bandianxuediao/TTP229_TouchPad/project_process.md

# TT229_TouchPad
 使用TTP229触摸控制芯片开发的一款4x4触摸矩阵键盘，两片74hc595级联控制16个双色LED灯。<br/>

>2018年4月30日<br/>
>>创建原理图，收集一些文档资料<br/>

>2018年5月5月10日<br/>
>>测试代码完成，开始V2版本布局布线<br/>
>>第一版本是为了快速验证方案，第二版又修改了LED控制方式，使用一个引脚控制两个灯。

>2018年5月12日<br/>
>>V2版电路板投板

芯片返回有错，事事不顺啊。

>2018年5月27日 23:30
>>第三版焊接之后发现还是有问题，干扰太大。不知从何入手，已经给官方技术支持发邮件，等待回复！</br>
>>看这板子发呆，突然想到会不会跟我喊姐有关系呢？芯片上面残留了不少的松香，松香会不会导致TTP229的因脚趾间短路呢？万用表一个一个的测了一遍完全没有短路的迹象啊。

>2018年5月28日 23:45
>>昨天晚上考虑松香的问题，早起就把一块焊好的板子装进包里带到公司使用公司的洗板水好好刷了一下。（洗板水已购买，暂未到货。）并在上班之前使用STM32F103C8T6核心板简单测试了一下，意外地发现效果还不错。于是欢喜的装回包里，晚上回来又换回正点原子精英板测试。发现效果又变差了，但总体上比清洗松香之前改善了很多。只敢小心翼翼的去按按键，不舍得做暴力测试。

>2018年5月30日 0:50
>>29日加班回来就焊接完成另外一块板子，在测试的过程中不经意的拿了一个立创商城的小的原件袋敷在案件上面。就是这一个不经意的举动，却足以一扫这些日子聚集在心头的阴霾。因为这个测试结果实在太漂亮了，按键的干扰几乎可以忽略不计。虽然不知道具体原因是什么，但是想来那么多的厂家没有将PCB直接露出来给客户按的也就有些理解了。</br>
>>翻出之前买的TTP229Demo板，发现它的按键上面全部都是盖油的。然后搜索了淘宝的一些触摸按键产品，根据他们贴出来的图片也能很明显的观察出来多数都是PCB按键上面盖油处理。</br>
>>OK,这次算是真相大白了。终于可以睡个安生觉了。**安安**
