bandianxuediao/TTP229_TouchPad/DXP/PCB1--BOOM.xlsx

Comment | Designator | Footprint | LibRef | Quantity
102 | C1 | 0603p | 电容-NPO-0603 | 1
104 | C2, C10, C11 | 0603p | 电容-NPO-0603 | 3
15pF | C3, C9 | 0603p | Cap | 2
22pF(再选择22-50之间容值备用) | C4, C5, C7, C8 | 0603p | Cap | 4
2xLED | D1, D2, D3, D4, D5, D6, D7, D8, D9, D10, D11, D12, D13, D14, D15, D16 | LED | 2xLED | 16
Header 5 | P1, P2 | XH-5P-2.54 | Header 5 | 2
1M | R3 | 0603p | 电阻-0603 | 1
10K | R5, R6 | 0603p | Res2 | 2
150R | R7, R8, R9, R10, R11, R12, R13, R14, R15, R16, R17, R18, R19, R20, R21, R22, R23, R24, R25, R26, R27, R28, R29, R30, R31, R32, R33, R34, R35, R36, R37, R38 | 0603p | 电阻-0603 | 32
TouchPad | TouchPad1, TouchPad5, TouchPad9, TouchPad13 | TOUCHKEYBIG | TouchPad | 4
TouchPad | TouchPad2, TouchPad3, TouchPad4, TouchPad6, TouchPad7, TouchPad8, TouchPad10, TouchPad11, TouchPad12, TouchPad14, TouchPad15, TouchPad16 | TOUCHKEY | TouchPad | 12
TTP229-L | U1 | LC-SSOP-28_150MIL | TTP229-L | 1
74HC595 | U2, U3 | LC-SOP-16_150MIL | 74HCT595 | 2
