bandianxuediao/TTP229_TouchPad/DXP/触摸键盘.DXF

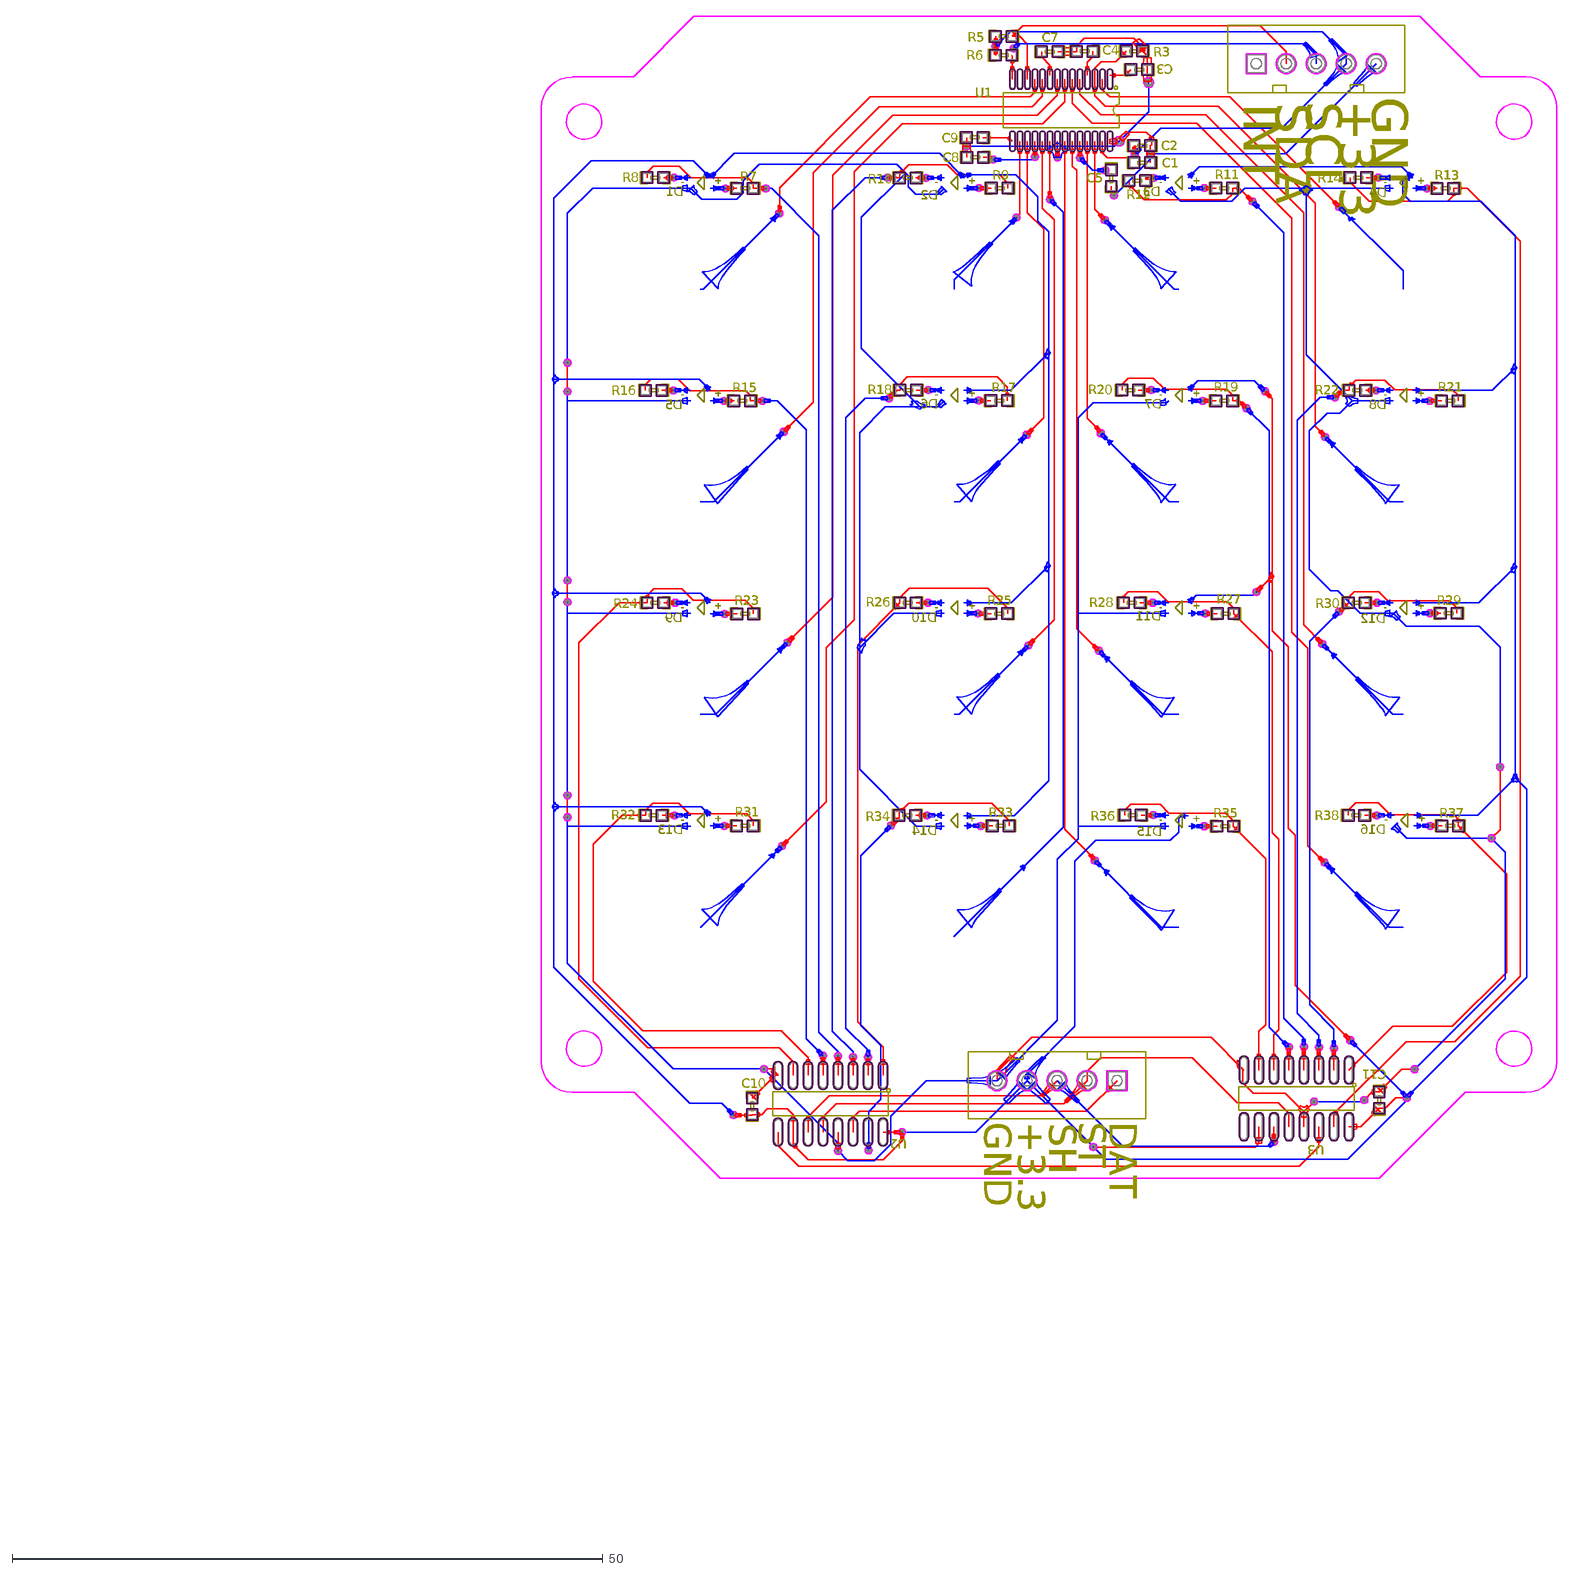
[picture p3: CAD file, 2018-06-02]
DXP/触摸键盘.DXF
GND
+3.3
SCL
SDA
INT
SH
ST
DAT
C1
C2
C3
C4
C5
C7
C8
C9
C10
C11
+
-
D1
D2
D3
D4
D5
D6
D7
D8
D9
D10
D11
D12
D13
D14
D15
D16
R3
R5
R6
R7
R8
R9
R10
R11
R12
R13
R14
R23
R24
R25
R26
R27
R28
R29
R30
U1
U2
U3
R15
R16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
