bandianxuediao/TTP229_TouchPad/(list of files, cad)

Other CAD files:
DOC/16键键盘带读卡.dwg
