bandianxuediao/TTP229_TouchPad/DXP/PCB_Project1.pdf

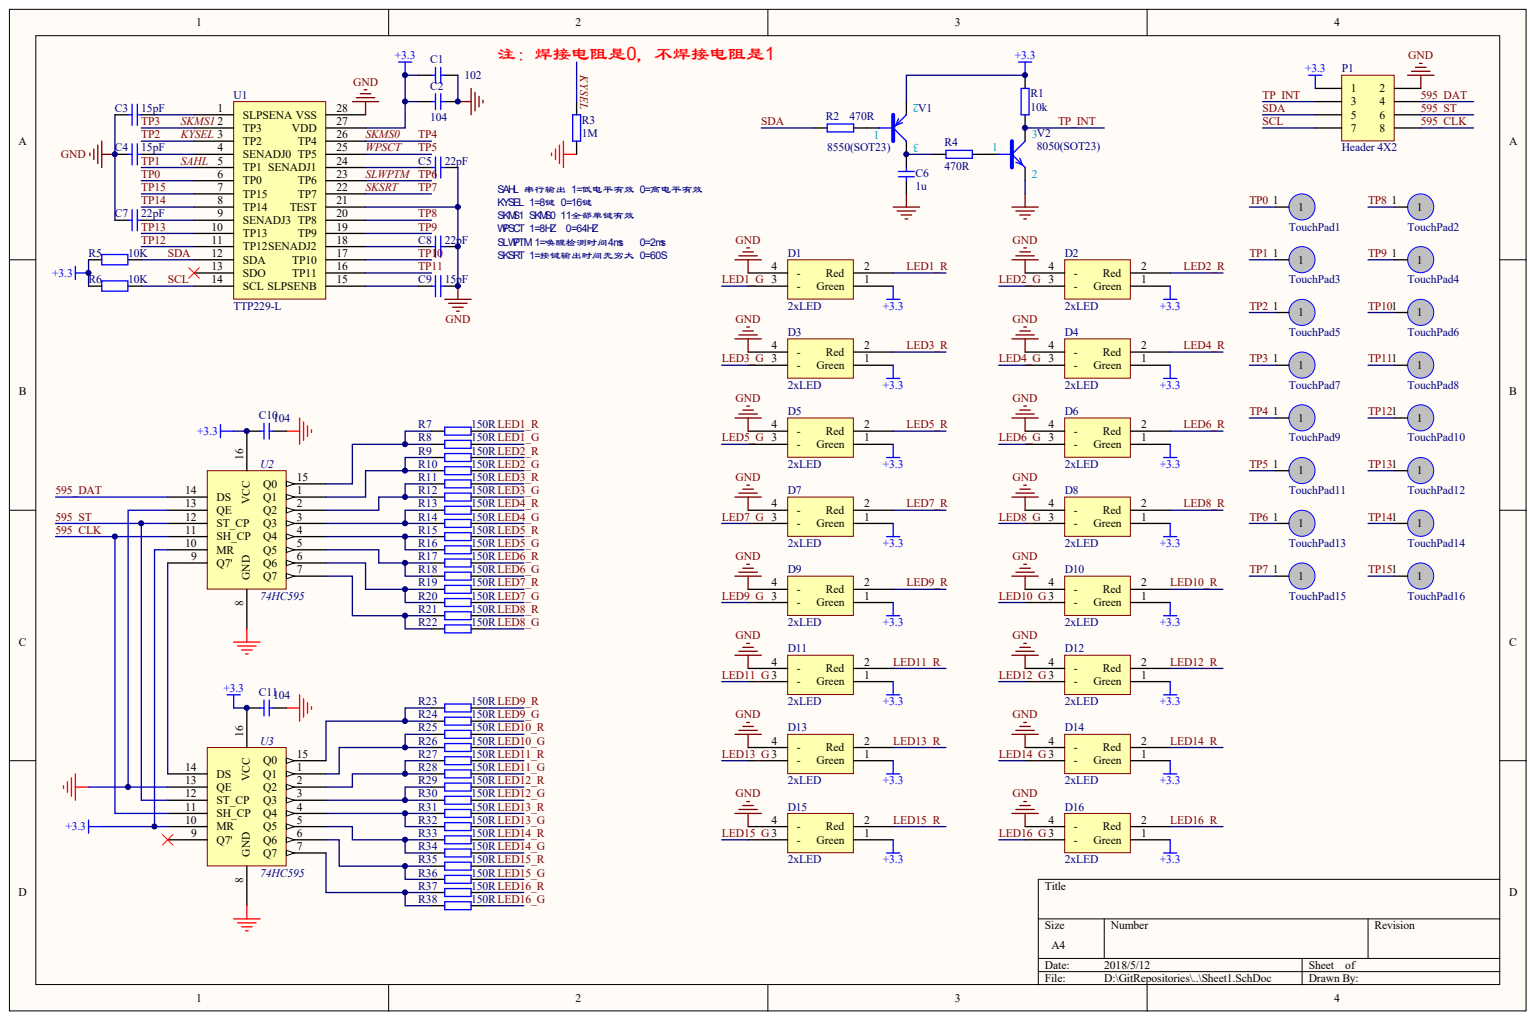
[picture p4: page 1]

22p F 9 | 2 0 T P
T P 1 3 1 0 | 1 9 T P

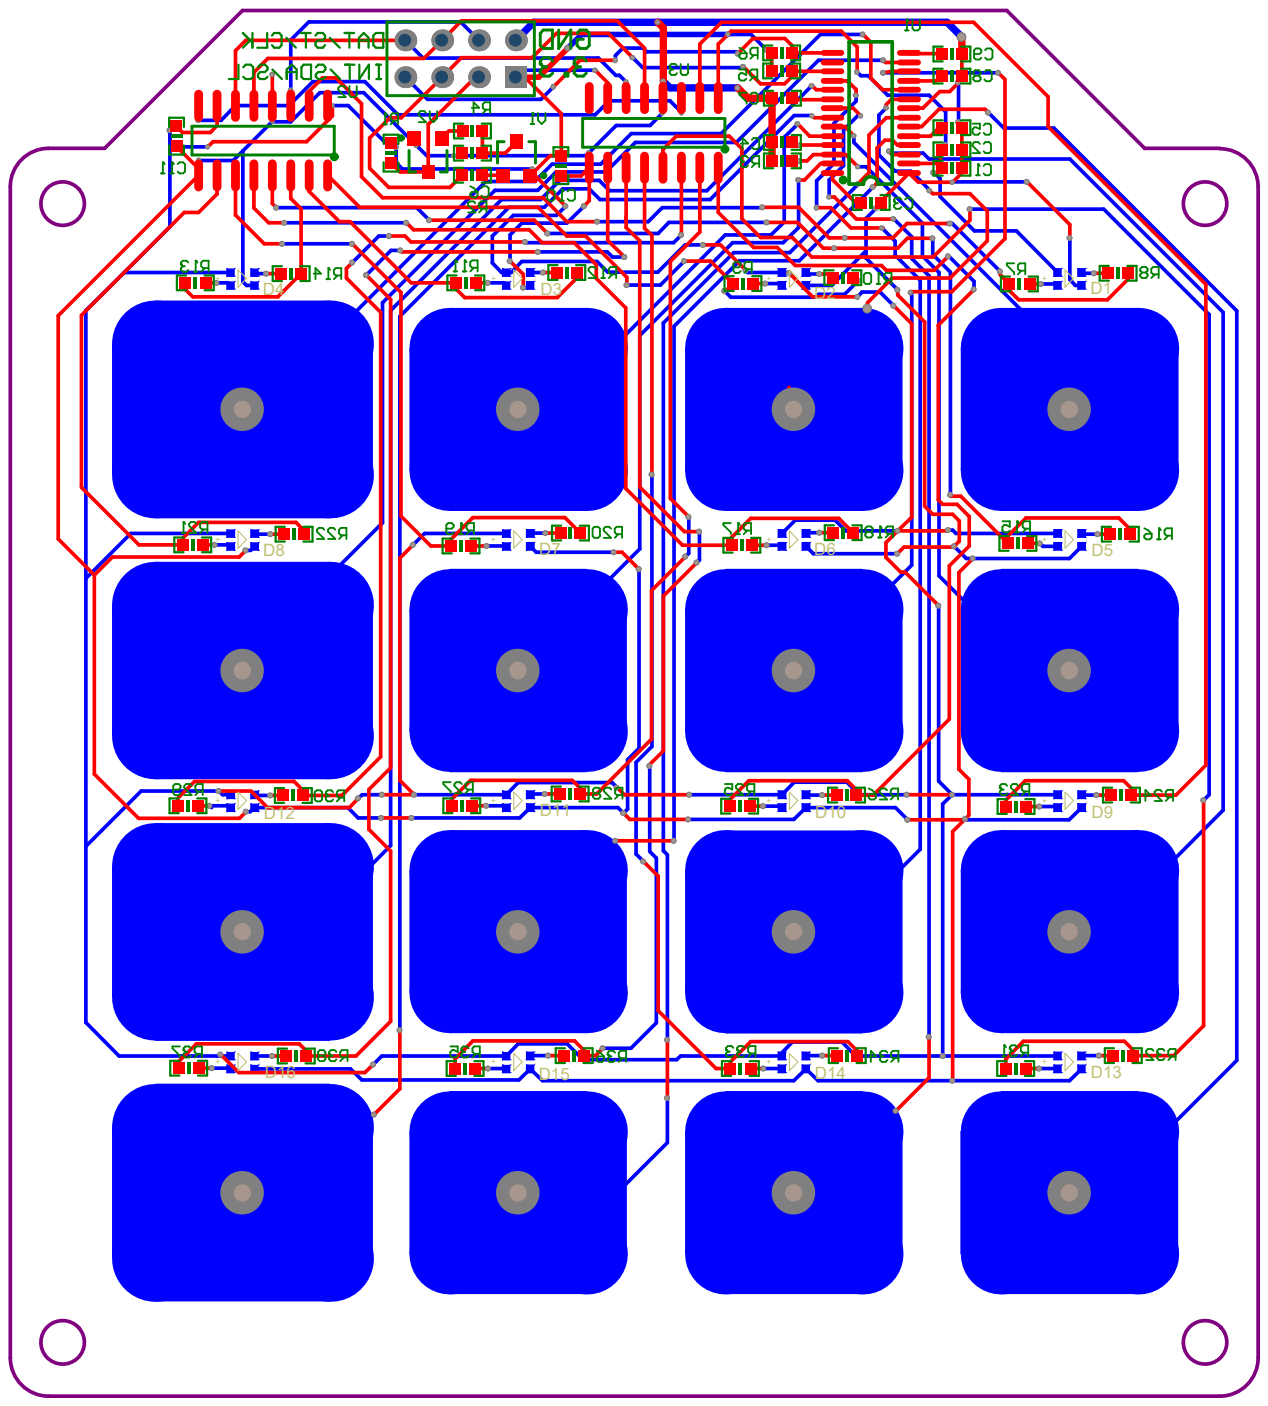
[picture p5: page 2]

Bill of Materials | <Parameter Title not found>
Source Data From: | PCB_Project1.PrjPCB
Project: | | PCB_Project1.PrjPCB
Variant: | | None
Creation Date: 2018/5/12 | 16:43:26
Print Date: | 43232 | 43232.69723
Footprint | Comment | LibRef | Designator | Description | Quantity
0603p | 102 | 电容-NPO-0603 | C1 | 0603/NPO | 1
0603p | 104 | 电容-NPO-0603 | C2, C10, C11 | 0603/NPO | 3
0603p | 15pF | Cap | C3, C4, C9 | Capacitor | 3
0603p | 22pF | Cap | C5, C7, C8 | Capacitor | 3
0603p | 1u | 电容-NPO-0603 | C6 | 0603/NPO | 1
LED | 2xLED | 2xLED | D1, D2, D3, D4, D5, D6, D7, D8, D9, D10,
| | | D11, D12, D13, D14, D15, D16 | | 16
HDR2X4 | Header 4X2 | Header 4X2 | P1 | Header, 4-Pin, Dual row | 1
0603p | 10k | Res2, 电阻-0603 | R1, R5, R6 | 0603/0.1000w/75v, Resistor | 3
0603p | 470R | 电阻-0603 | R2, R4 | 0603/0.1000w/75v | 2
0603p | 1M | 电阻-0603 | R3 | 0603/0.1000w/75v | 1
0603p | 150R | 电阻-0603 | R7, R8, R9, R10, R11, R12, R13, R14,
| | | R15, R16, R17, R18, R19, R20, R21, R22,
| | | R23, R24, R25, R26, R27, R28, R29, R30,
| | | R31, R32, R33, R34, R35, R36, R37, R38 | 0603/0.1000w/75v | 32
TOUCHKEY | TouchPad | TouchPad | TouchPad1, TouchPad2, TouchPad3,
TouchPad5, TouchPad6, TouchPad7, TouchPad9, TouchPad10, TouchPad11, TouchPad13, TouchPad14, TouchPad15 | 12
TouchPad16 | 4

## TOUCHKEYb

ig

| TouchPad | TouchPad | TouchPad4, TouchPad8, TouchPad12,
LC-SSOP- 28_150mil | TTP229-L | TTP229-L | U1 | 1
LC-SOP- 16_150mil | 74HC595 | 74HCT595 | U2, U3 | 2
SOT-23R | 8550(SOT23) | 8550(SOT23) | V1 | 1
SOT-23R | 8050(SOT23) | 8050(SOT23) | V2 | 1
| | | | 87
Approved | | Notes
