bandianxuediao/TTP229_TouchPad/DOC/TTP229B.pdf

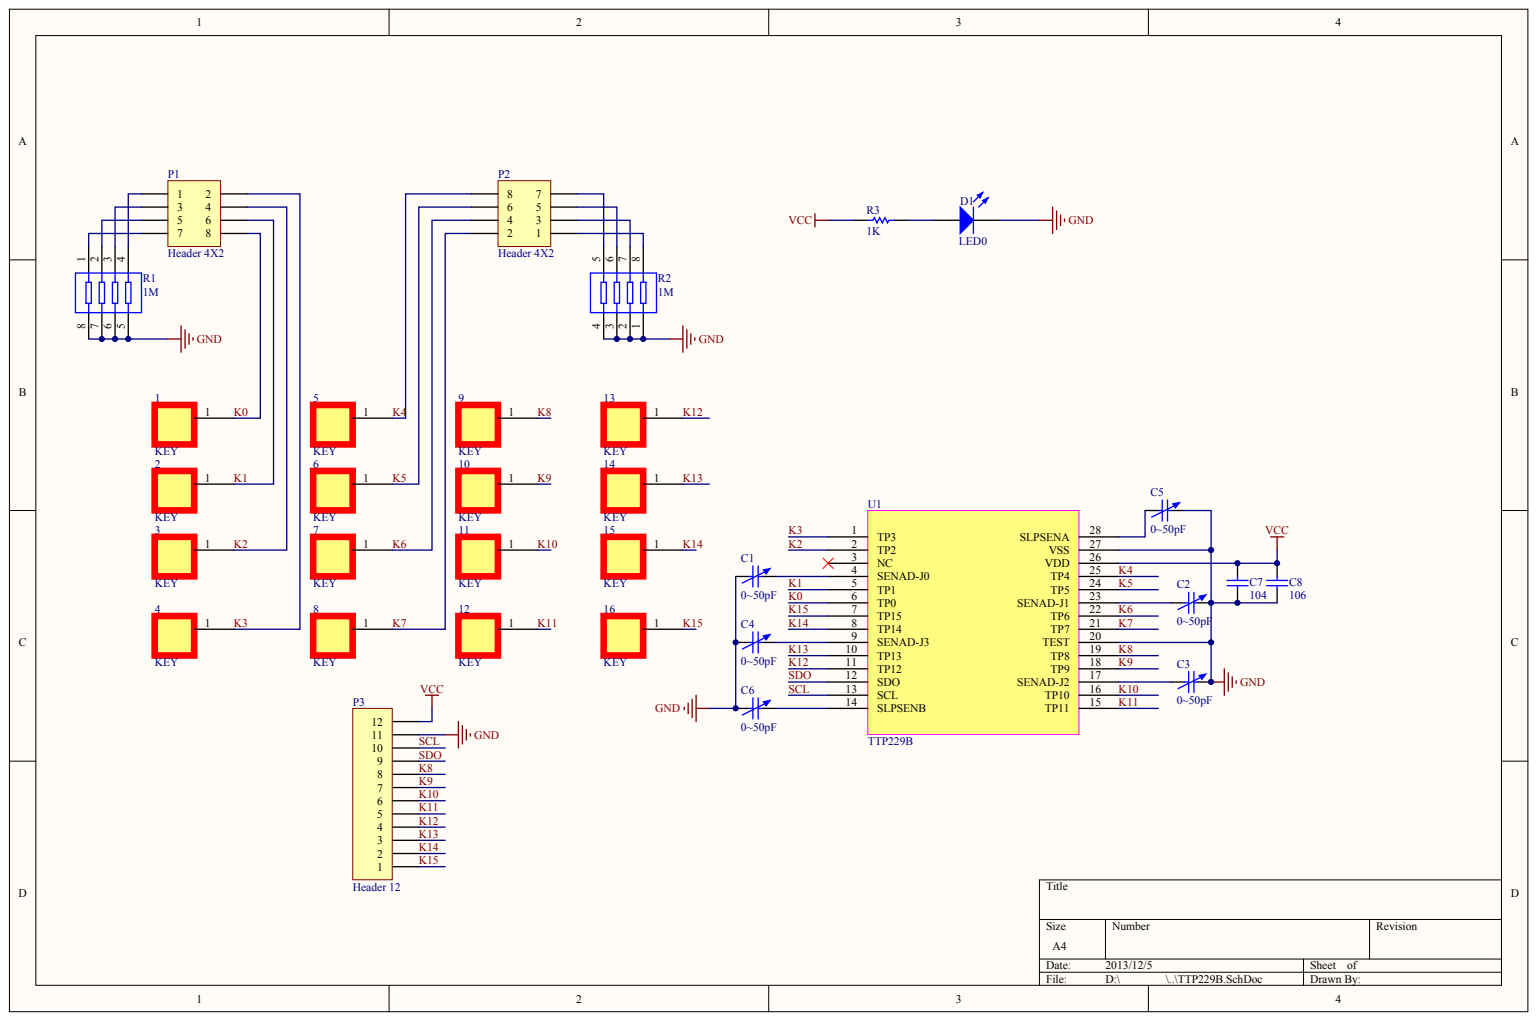
[picture p6: page 1]

Comment | Description | Designator | Footprint | LibRef | Quantity
KEY | | 1, 2, 3, 4, 5, 6, 7, 8, 9, 10, 11, 12, 13, 14, 15, 16 | KEY-8 | KEY | 16
0~50pF | Variable or Adjustable Capacitor | C1, C2, C3, C4, C5, C6 | 0805 | Cap Var | 6
104 | Capacitor | C7 | 0805 | Cap | 1
106 | Capacitor | C8 | 0805 | Cap | 1
LED0 | Typical INFRARED GaAs LED | D1 | LED-0805 | LED0 | 1
Header 4X2 | Header, 4-Pin, Dual row | P1, P2 | HDR2X4 | Header 4X2 | 2
Header 12 | Header, 12-Pin | P3 | HDR1X12 | Header 12 | 1
1M | | R1, R2 | SOP-0603-4 | RES_PACK4 | 2
1K | Resistor | R3 | 0805 | Res1 | 1
TTP229B | | U1 | TS-SOP28 | TTP229B | 1
