bandianxuediao/TTP229_TouchPad/DOC/2501系列 插座 1_5P 2.5mm 直针_PDF_C132457_2018-01-05.pdf

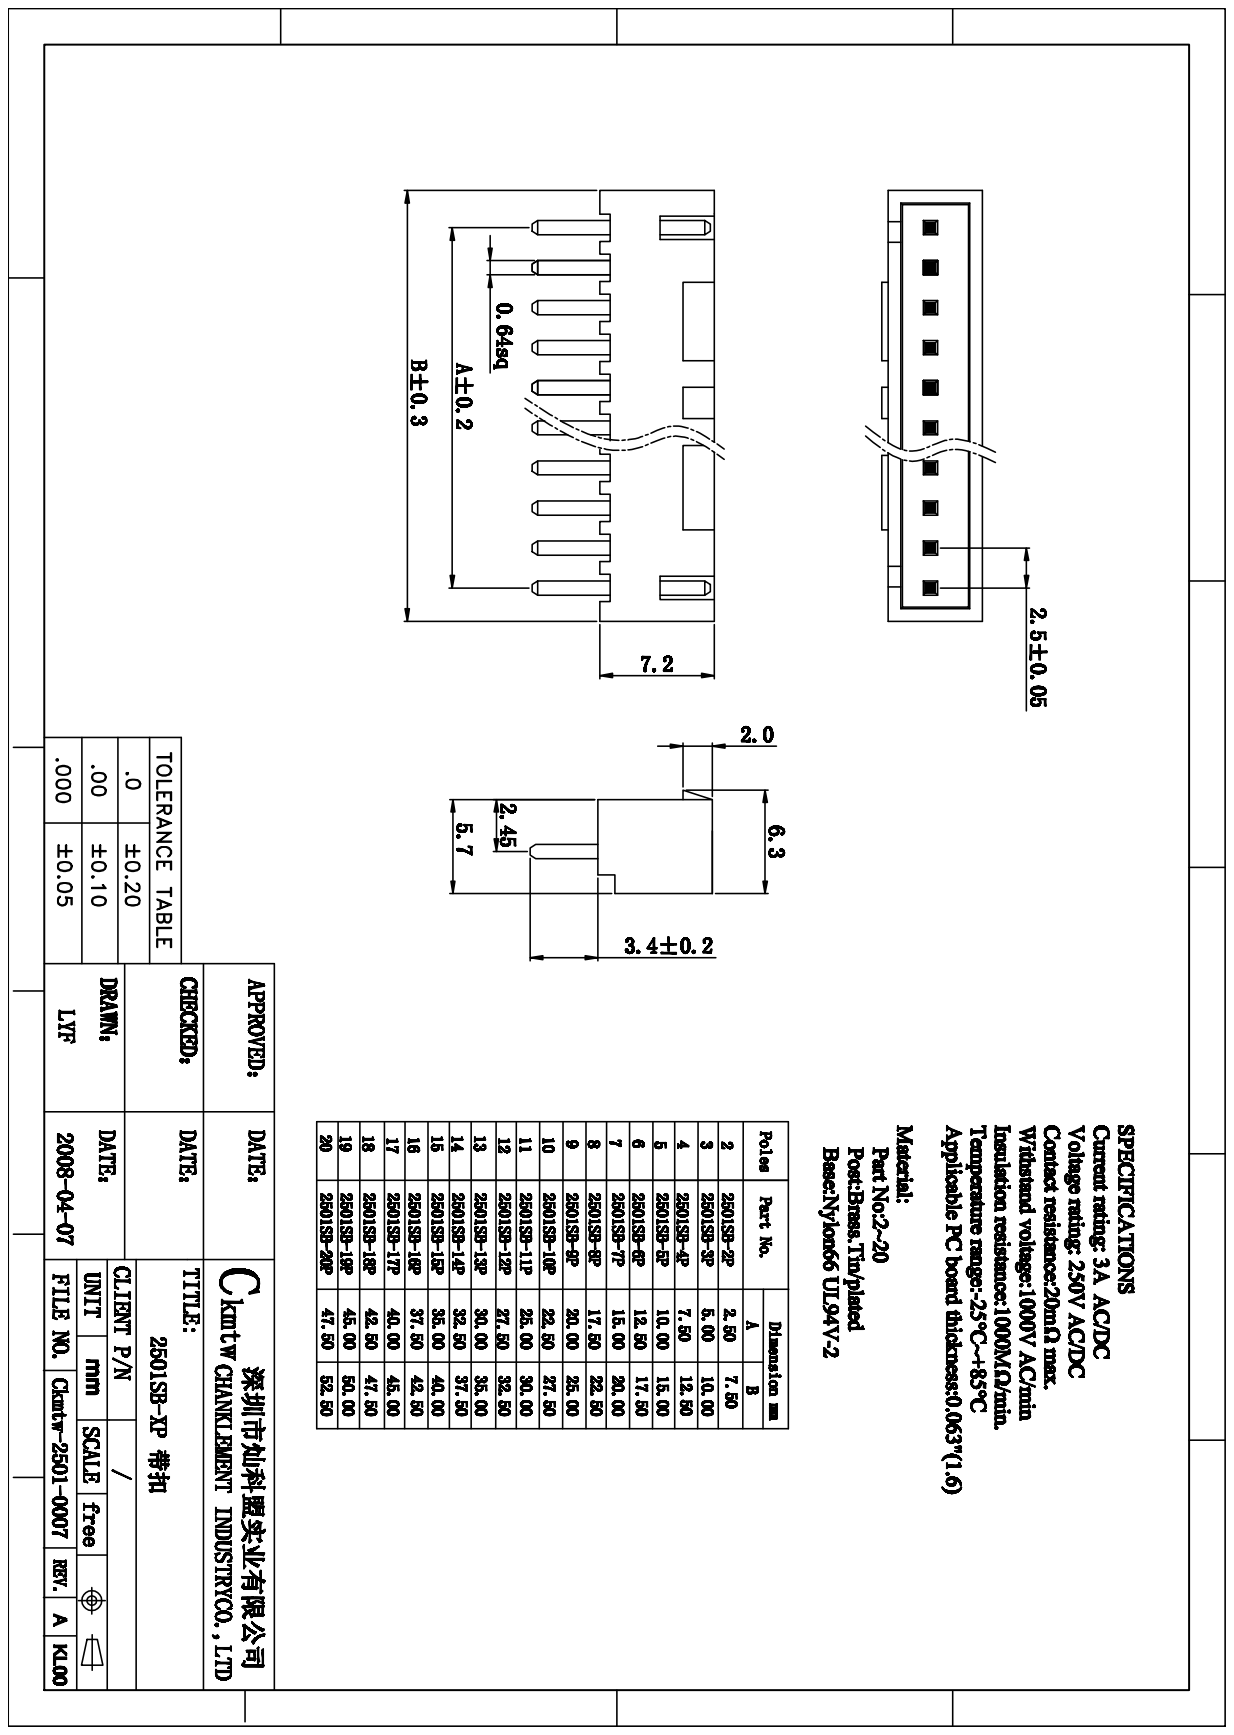
[picture p7: page 1]
