bandianxuediao/TTP229_TouchPad/DOC/16键键盘带读卡-Model.pdf

1

86

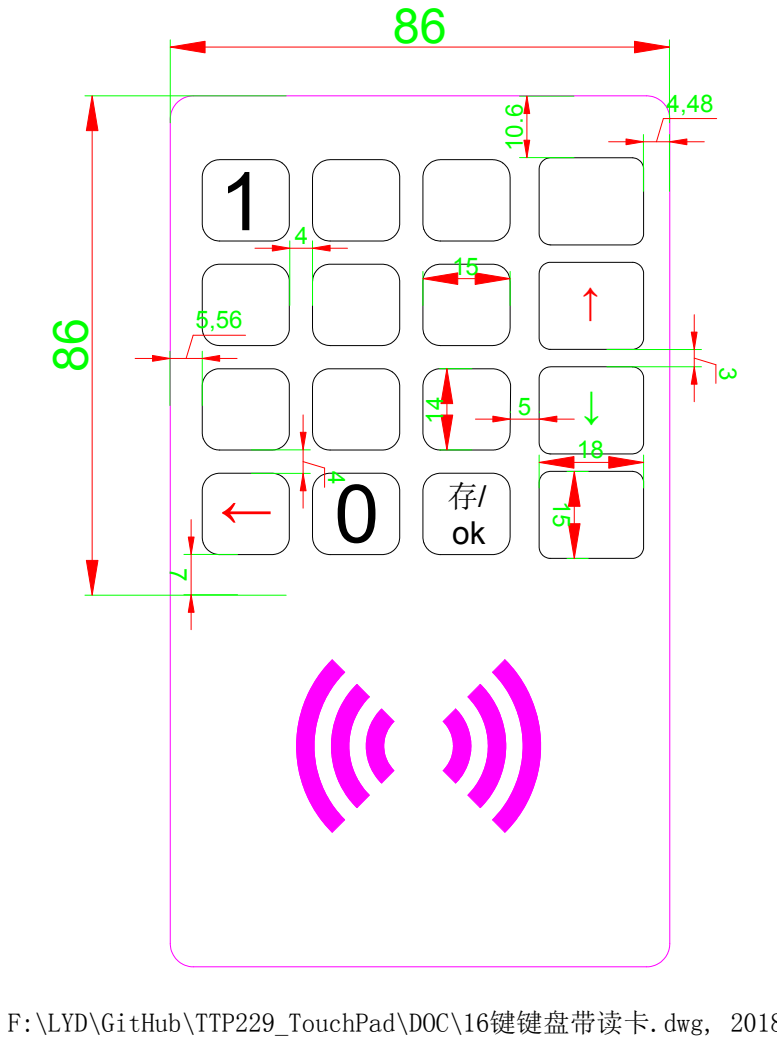
[picture p8: page 1]

F:\LYD\GitHub\TTP229_TouchPad\DOC\16键键盘带读卡.dwg, 2018-05-10 16:19
