bandianxuediao/TTP229_TouchPad/(list of files, drawings)

Other design files:
DOC/方案验证仿真电路(multisim).ms12
DXP/PCB1.PcbDoc
DXP/PCB_Project1.PrjPCB
DXP/PCB_Project11/PCB1.PcbLib
DXP/PCB_Project11/PCB_Project1.SCHLIB
DXP/Sheet1.SchDoc
