bandianxuediao/TTP229_TouchPad/Program/Project/includes.h

#ifndef _INCLUDES_H_
#define _INCLUDES_H_
#include <string.h>
#include <stdio.h>
#include <stdlib.h>
//#include "core_cm3.h"
#include "stm32f10x.h"
#include "stm32f10x_tim.h"
#include "stm32f10x_spi.h"
#include "stm32f10x_adc.h"
#include "stm32f10x.h"
#include "SYSTICK.h"
#include "usart.h"
#include "sys.h"



#include "PAD_IIC.h"
#include "pad.h"
#include "HC595.h"
//#include "stm32f4xx_conf.h"
//#include "irmpsystem.h"
//#include "core_cm3.h"
//#include "system_stm32f10x.h"




#endif
