bandianxuediao/TTP229_TouchPad/(commit log)

2018-04-30 创建原理图
    创建原理图，收集一些文档资料
    [PCB1.PcbDoc, PCB_Project1.PrjPCB, Sheet1.SchDoc, Sheet1.sch, Sheet1.~(13).SchDoc, Sheet1.~(15).SchDoc]
2018-05-01 原理图
    修改
    [Sheet1.SchDoc]
2018-05-01 LayOut
    pcb基本完成，早上再走电源，还有中断处理电路
    [PCB1.PcbDoc, Sheet1.SchDoc, Sheet1.~(13).SchDoc, Sheet1.~(15).SchDoc]
2018-05-02 方案验证投板
    方案验证投板
    [PCB1.PcbDoc, PCB_Project1.PrjPCB, Sheet1.SchDoc]
2018-05-06 复制过来项目进展
2018-05-07 创建代码
    创建代码
2018-05-07 添加代码
2018-05-08 DXP_V2分支
    创建分支
    [PCB_Project1.PrjPCB, Sheet1.SchDoc]
2018-05-08 代码准备
2018-05-09 datasheet翻译读数据时序
    datasheet翻译读数据时序
2018-05-09 按照datasheet更新代码
    更新读取按键时序，示例代码有错误，导致思路出错。重新查看数据手册修改代码！
2018-05-09 代码基本测试完成
    代码测试基本完成，后期还需要修改亮灯控制方式，准备采用前辈经典电路。
2018-05-10 123
    123
    [16键键盘带读卡.dwg, PCB1.PcbDoc, Sheet1.SchDoc]
2018-05-10 V2版布局布线
    还剩下一个74HC595没有布完
    [PCB1.PcbDoc, PCB_Project1.PrjPCB, Sheet1.SchDoc]
2018-05-12 V2版布线完毕
    [PCB1.PcbDoc, PCB_Project1.PrjPCB]
2018-05-12 铺地
    铺地
    [PCB1.PcbDoc, PCB_Project1.PrjPCB]
2018-05-12 此版本二次打样
    此版本二次打样
2018-05-14 程序文件整理
    代码整理，注释修改
2018-05-17 仿真电路、修改代码
    1、添加LED控制部分的仿真电路，测试通过
    2、修改代码结构、修改led控制
2018-05-17 添加文档，修改仿真电路
    [方案验证仿真电路(multisim).ms12]
2018-05-19 修改PCB
    干扰太大，考虑是布局，PAD的原因。
    [PCB1.PcbDoc, PCB1.PcbLib, PCB_Project1.SCHLIB, Sheet1.SchDoc]
2018-05-28 更新代码
    使用核心板调试，清理板子残留松香
2018-05-29 找到按键干扰的因素，更新进度
2018-05-31 Modify the project source code.
    1、delete some unused file.
    2、delete superfluous code.
2018-06-02 添加CAD文件
    生成的CAD文件没有bottom的pad，原因未知
    [触摸键盘.DXF]
2018-07-02 添加BOOM，修改容值
    添加BOOM，修改容值
    [PCB1--BOOM.xlsx, PCB_Project1.PrjPCB, Sheet1.SchDoc]
